winchesterwolf1/Curing-Oven/README.md

Codebase to run a simple UI for a UV curing station created from a UV bulb, Arduino Nano, SPI OLED screen, and a digital encoder
