winchesterwolf1/Curing-Oven/Curing Oven HW/Mechanical/Files V14/Rear Casing.stl

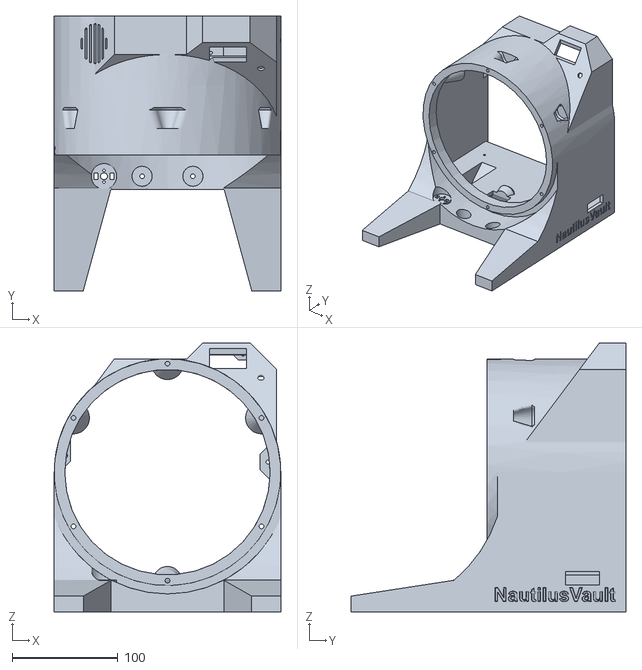
[picture p1: CAD file, 2025-09-29]
Curing Oven HW/Mechanical/Files V14/Rear Casing.stl
214.0 x 259.5 x 254.1
