winchesterwolf1/Curing-Oven/Curing Oven HW/Mechanical/Files V14/Spur Gear.stl

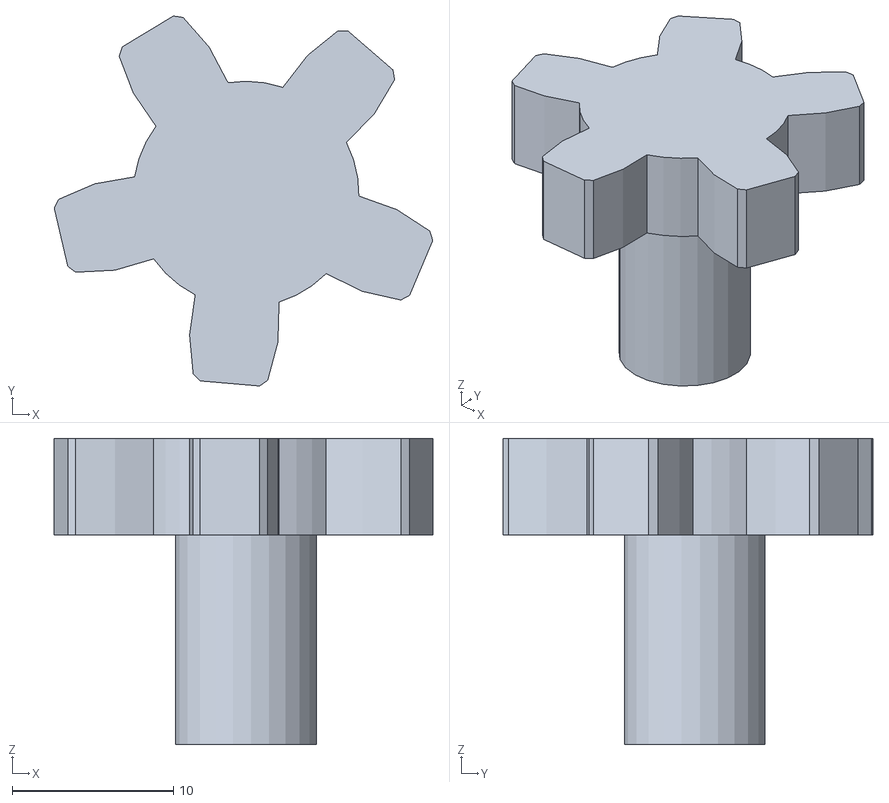
[picture p2: CAD file, 2025-09-29]
Curing Oven HW/Mechanical/Files V14/Spur Gear.stl
23.5 x 22.9 x 19.0
