winchesterwolf1/Curing-Oven/Curing Oven HW/Mechanical/Files V14/Front Brace.stl

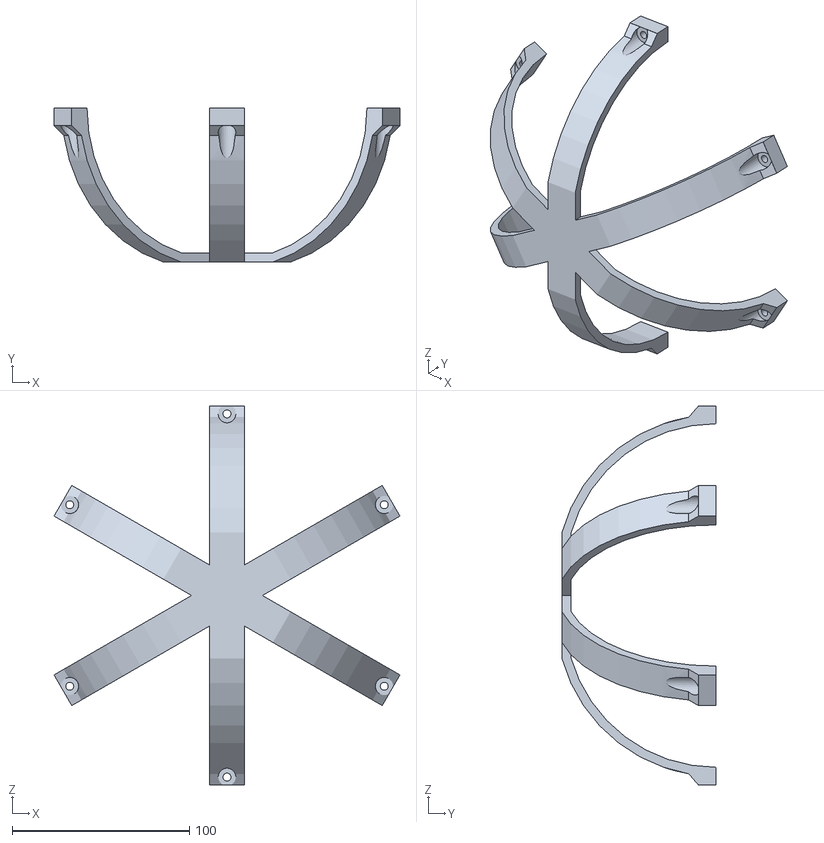
[picture p4: CAD file, 2025-09-29]
Curing Oven HW/Mechanical/Files V14/Front Brace.stl
195.3 x 87.0 x 214.0
