winchesterwolf1/Curing-Oven/Curing Oven HW/Mechanical/Files V14/Front Hinge.stl

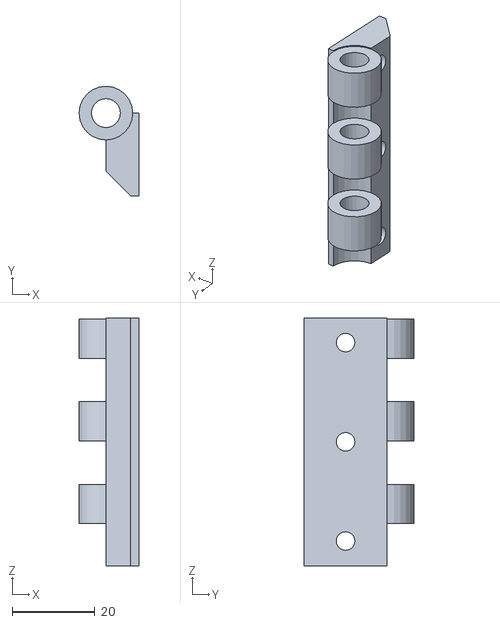
[picture p5: CAD file, 2025-09-29]
Curing Oven HW/Mechanical/Files V14/Front Hinge.stl
14.5 x 26.5 x 60.0
