winchesterwolf1/Curing-Oven/Curing Oven HW/Mechanical/Files V14/Front Ring.stl

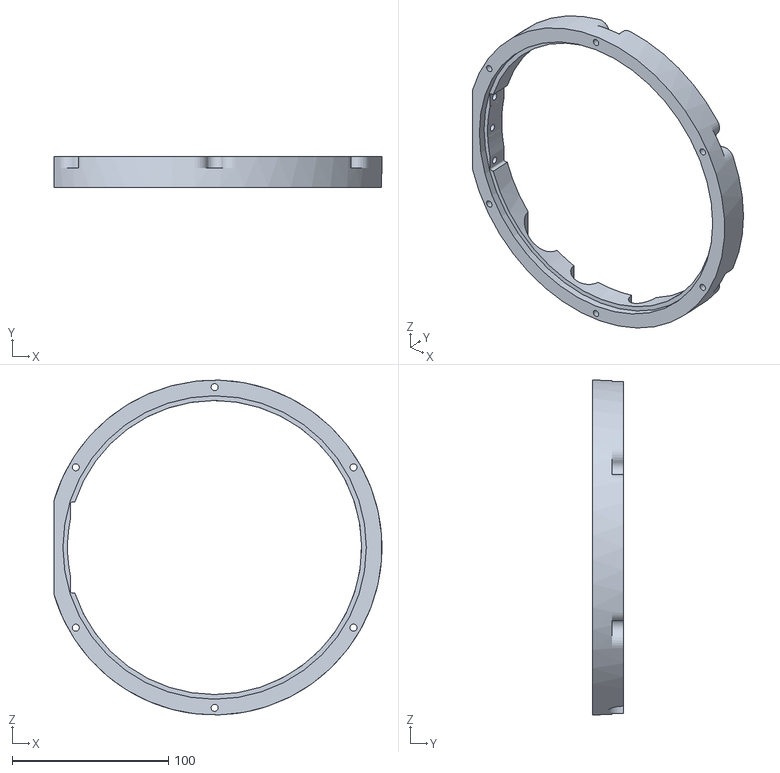
[picture p6: CAD file, 2025-09-29]
Curing Oven HW/Mechanical/Files V14/Front Ring.stl
209.7 x 20.0 x 213.9
