winchesterwolf1/Curing-Oven/Curing Oven HW/Mechanical/Files V14/Rotating Base Mount.stl

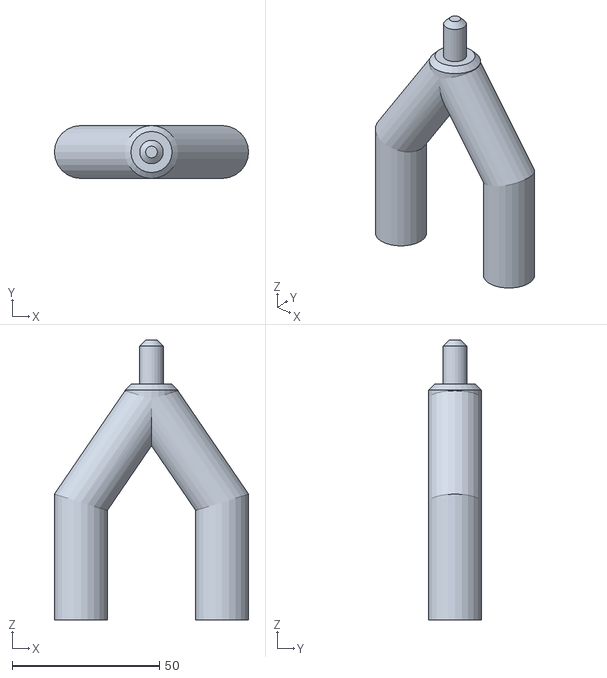
[picture p7: CAD file, 2025-09-29]
Curing Oven HW/Mechanical/Files V14/Rotating Base Mount.stl
66.0 x 18.0 x 95.1
