winchesterwolf1/Curing-Oven/Curing Oven HW/Mechanical/Files V14/Rear Hatch.stl

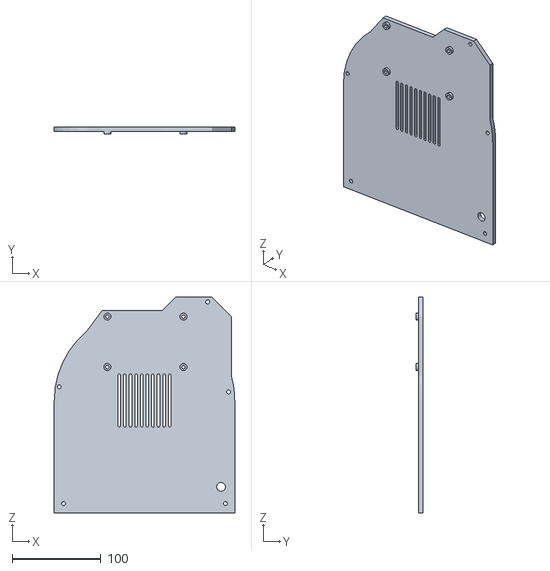
[picture p8: CAD file, 2025-09-29]
Curing Oven HW/Mechanical/Files V14/Rear Hatch.stl
204.0 x 8.00 x 244.1
