winchesterwolf1/Curing-Oven/Curing Oven HW/Mechanical/Files V14/Rotating Base.stl

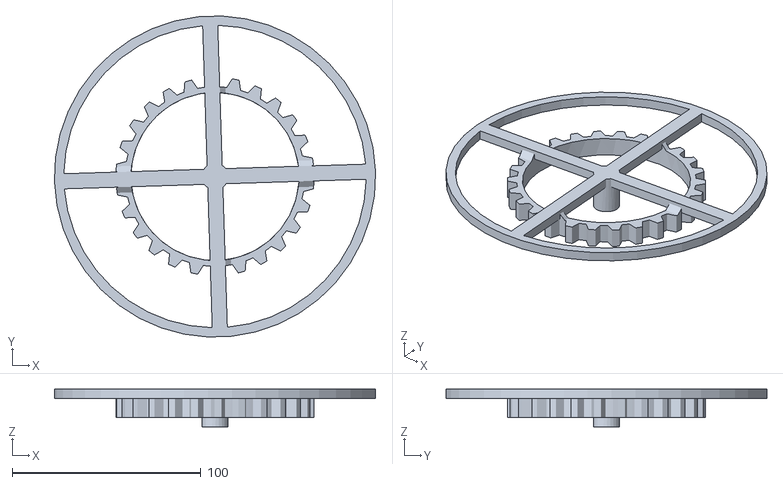
[picture p9: CAD file, 2025-09-29]
Curing Oven HW/Mechanical/Files V14/Rotating Base.stl
169.9 x 169.8 x 20.0
