winchesterwolf1/Curing-Oven/(list of files, cad)

Other CAD files:
Curing Oven HW/Mechanical/Files V14/Rear Ring.stl
