winchesterwolf1/Curing-Oven/Curing Oven HW/Electrical/Curing_Oven_PCBs/UV_Curing-PCB.brd

## EAGLE design Curing Oven HW/Electrical/Curing_Oven_PCBs/UV_Curing-PCB.brd (2025-10-28)

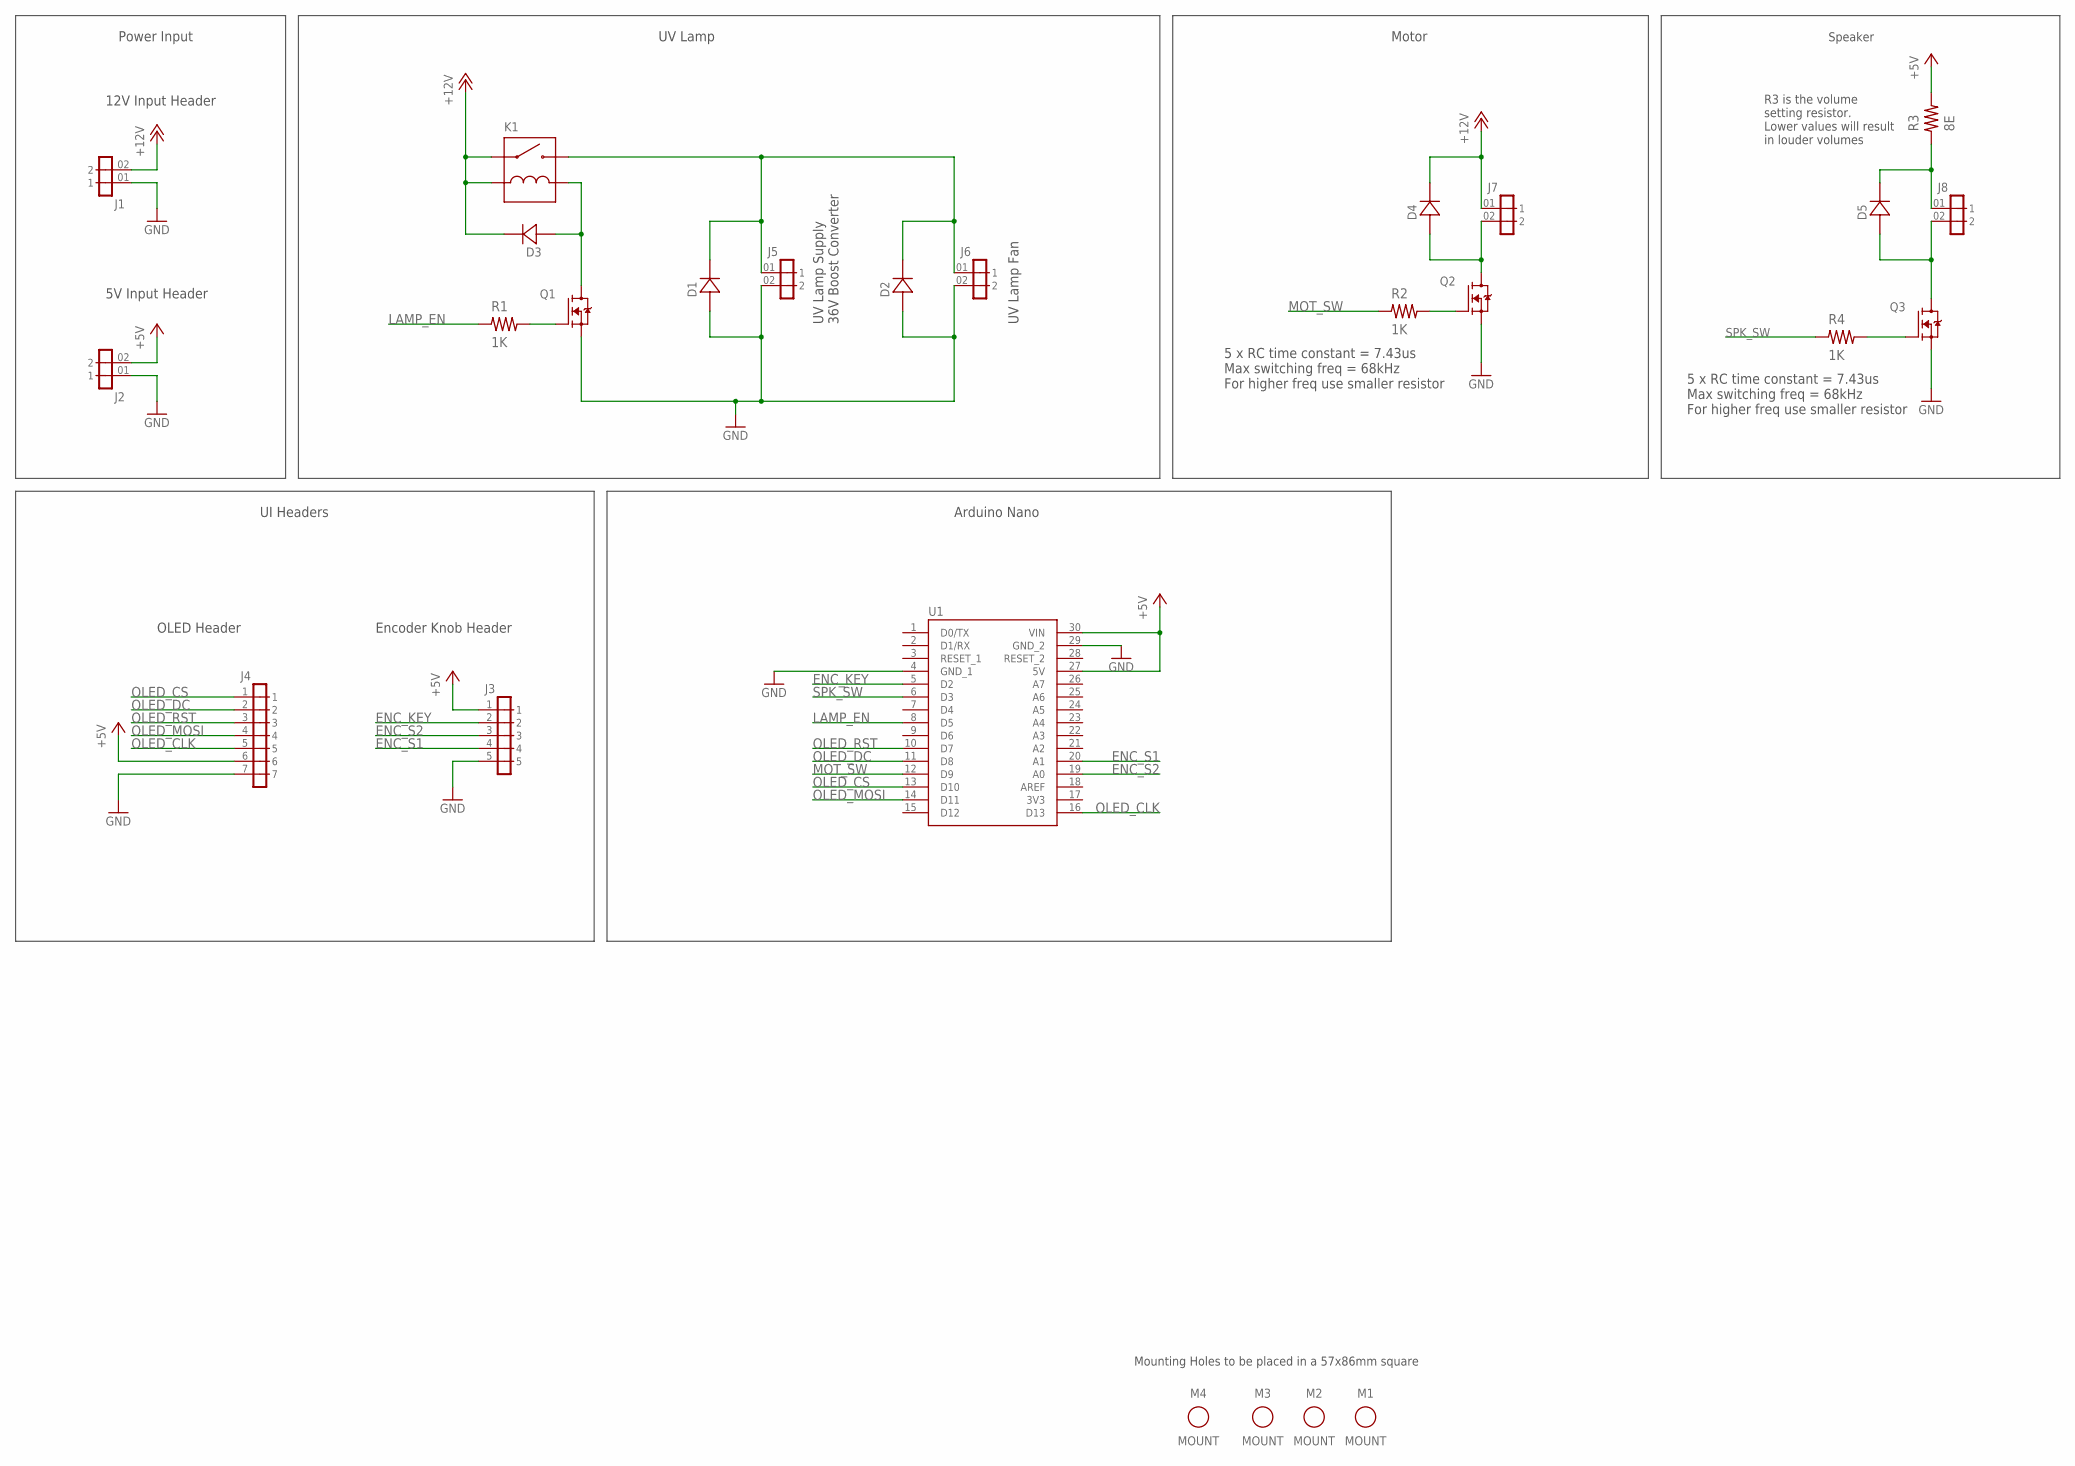
[picture p10: schematic UV_Curing-PCB.sch]

Parts:
D1, D2, D3, D4, D5: 400V; DIOAD520W79L463D238
J1, J2, J5, J6, J7, J8: PINHEADER-2POS-2.54MM; 254-1X02-PIN
J3: PINHEADER-5POS-2.54MM; 254-1X05-PIN
J4: PINHEADER-7POS-2.54MM; 254-1X07-PIN
K1: 25V; JY25HK505
M1, M2, M3, M4: MOUNTING_HOLE; M4_NP_MOUNTING_HOLE
Q1, Q2, Q3: 55V; TO254P1016X419X2286-3
R1, R2, R4: 1K; RES-THRU
R3: 8E; RES-THRU
U1: A000005; MODULE_A000005

Connections:
3V3: U1.17 (3V3)
+5V: J2.02 (2), J3.1, J4.6, R3.2, U1.27 (5V), U1.30 (VIN)
+12V: D3.C, D4.C, J1.02 (2), J7.01 (1), K1.8 (COIL_1), K1.16 (COM)
ENC_KEY: J3.2, U1.5 (D2)
ENC_S1: J3.4, U1.20 (A1)
ENC_S2: J3.3, U1.19 (A0)
GND: D1.A, D2.A, J1.01 (1), J2.01 (1), J3.5, J4.7, J5.02 (2), J6.02 (2), Q1.3 (S), Q2.3 (S), Q3.3 (S), U1.4 (GND_1), U1.29 (GND_2)
LAMP_EN: R1.1, U1.8 (D5)
MOT_SW: R2.1, U1.12 (D9)
unnamed: Q1.1 (G), R1.2
unnamed: D1.C, D2.C, J5.01 (1), J6.01 (1), K1.13 (NO)
unnamed: D3.A, K1.9 (COIL_2), Q1.2 (D)
unnamed: Q2.1 (G), R2.2
unnamed: D4.A, J7.02 (2), Q2.2 (D)
unnamed: D5.C, J8.01 (1), R3.1
unnamed: D5.A, J8.02 (2), Q3.2 (D)
unnamed: Q3.1 (G), R4.2
OLED_CLK: J4.5, U1.16 (D13)
OLED_CS: J4.1, U1.13 (D10)
OLED_DC: J4.2, U1.11 (D8)
OLED_MOSI: J4.4, U1.14 (D11)
OLED_RST: J4.3, U1.10 (D7)
SPK_SW: R4.1, U1.6 (D3)

Notes on the sheet:
Arduino Nano
Power Input
12V Input Header
5V Input Header
UI Headers
OLED Header
Encoder Knob Header
UV Lamp
UV Lamp Supply 36V Boost Converter
UV Lamp Fan
Motor
5 x RC time constant = 7.43us Max switching freq = 68kHz For higher freq use smaller resistor
Speaker
R3 is the volume setting resistor. Lower values will result in louder volumes
Mounting Holes to be placed in a 57x86mm square

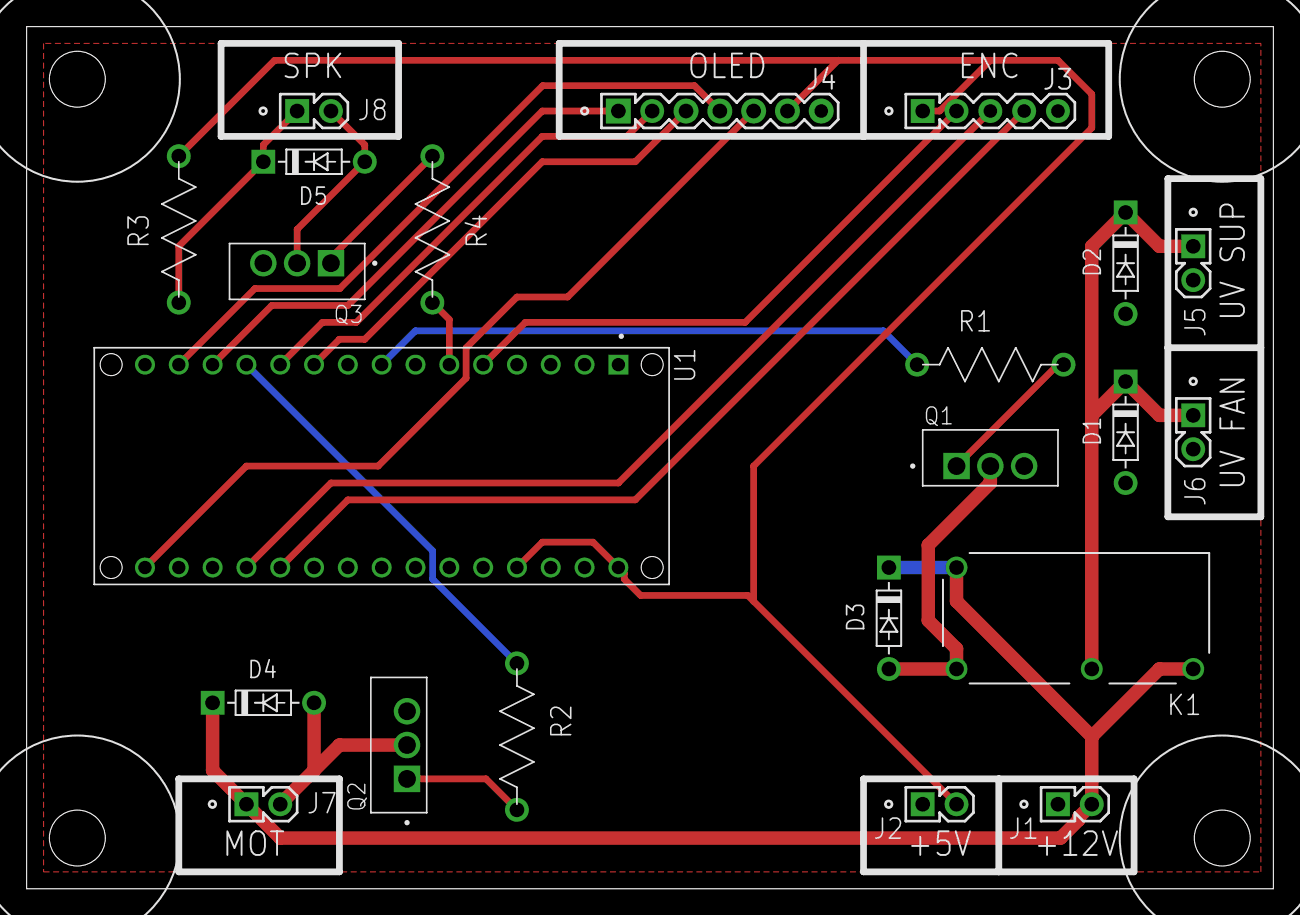
[picture p11: board UV_Curing-PCB.brd from above]

Board: 2 copper layers, 93.7 x 64.8 mm, 26 parts (0 on the bottom side), 22 nets.
