winchesterwolf1/Curing-Oven/(commit log)

2025-09-29 Initial Commits
    [Front Brace.stl, Front Hinge.stl, Front Ring.stl, Rear Casing.stl, Rear Hatch.stl, Rear Hinge.stl, Rear Ring.stl, Rotating Base Mount.stl]
2025-09-29 Added Speaker beeps and motor stuff to UI
2025-10-28 Updated PCB for fab manufacturing
    [UV_Curing-PCB.brd, UV_Curing-PCB.sch]
2025-10-28 Removed autosaves,
    Added Gerber outputs
2025-11-10 fixed error in encoder knob placement
    [Definitions.h]
